junior-programeer/ProyectoRobot/docs/diagramas/diagrama de bloques.jpeg

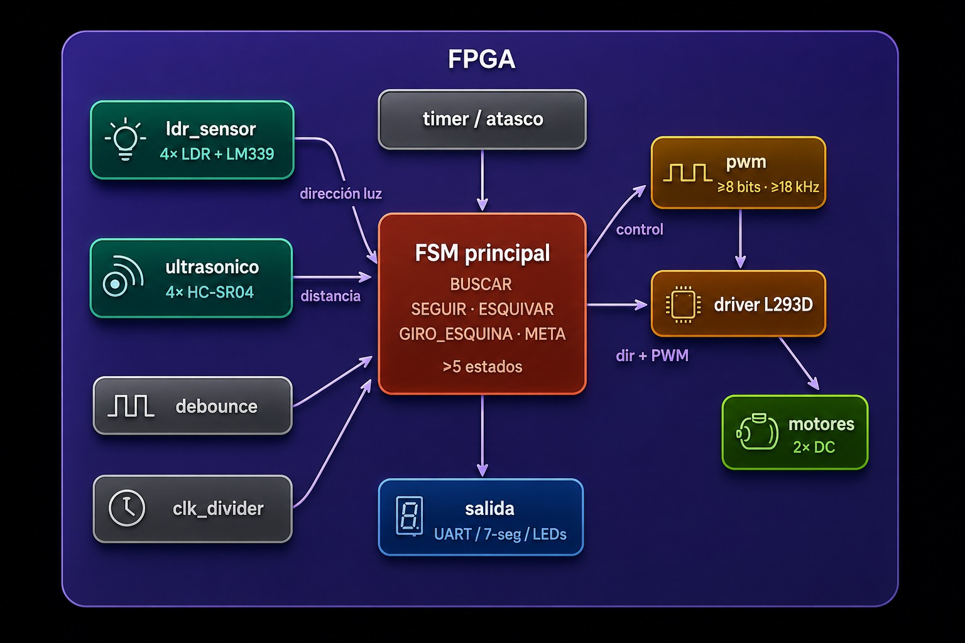
docs/diagramas/diagrama de bloques.jpeg
