junior-programeer/ProyectoRobot/docs/diagramas/diagrama fsm.png

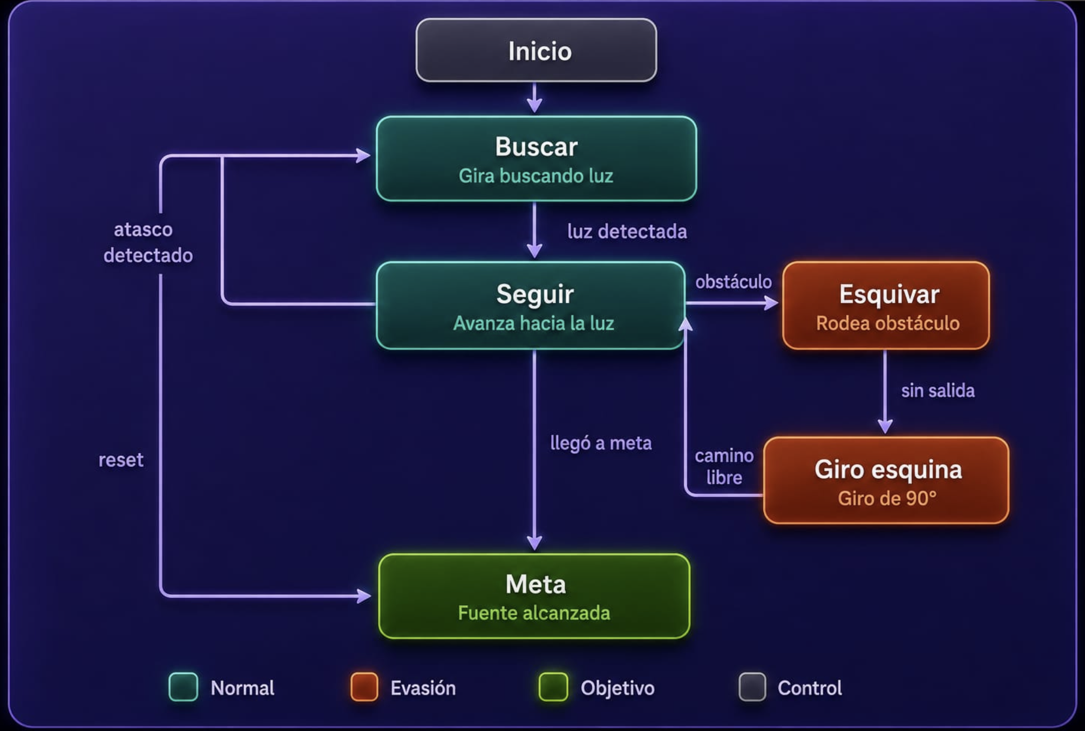
docs/diagramas/diagrama fsm.png
