junior-programeer/ProyectoRobot/docs/diagramas/diagrama-esquematico (patigrama)/placeholder.md

# Esquemático
El diagrama esquemático del circuito. Se muestran las conecciones y el alambrado necesario para el funcionamiento correcto de los sistemas de seguimiento y detección de obstaculos.
