junior-programeer/ProyectoRobot/codigo-vhdl/placeholder.md

# Código VHDL
Aquí va el código fuente del robot.
