junior-programeer/ProyectoRobot/docs/pines-fpga/placeholder.md

# Restricciones de Pines FPGA
Aquí va la asignación de pines de la DE10-Lite.
