junior-programeer/ProyectoRobot/docs/simulaciones/placeholder.md

# Simulaciones y Testbench
Aquí van los archivos de simulación y testbench.
