junior-programeer/ProyectoRobot/docs/datasheets/placeholder.md

# Datasheets
Aquí van los datasheets de los componentes.
