junior-programeer/ProyectoRobot/docs/diagramas/diagrama-esquematico (patigrama)/RobotSeguidor_circuit.png

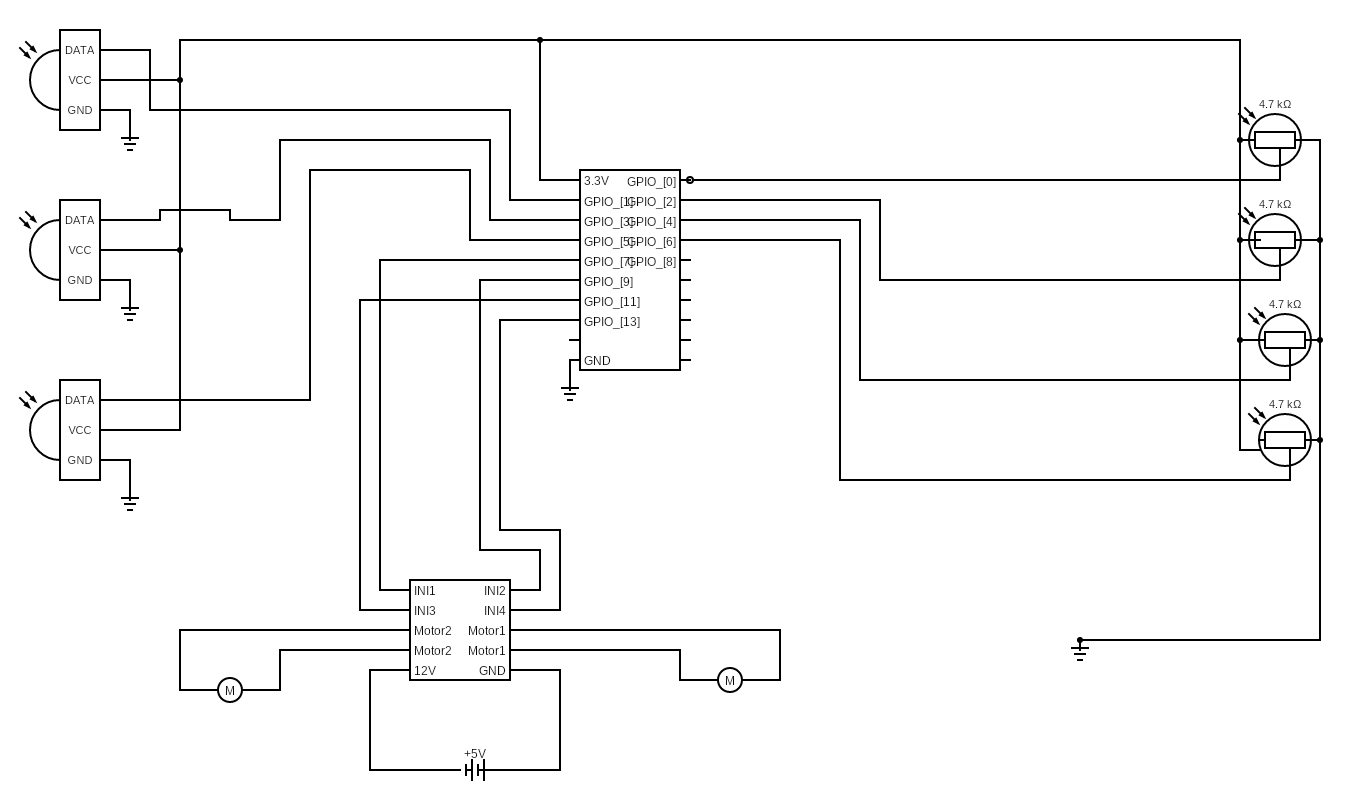
docs/diagramas/diagrama-esquematico (patigrama)/RobotSeguidor_circuit.png
