junior-programeer/ProyectoRobot/docs/simulaciones/Testbench.pdf

Testbench del Robot, Proyecto Final VLSI

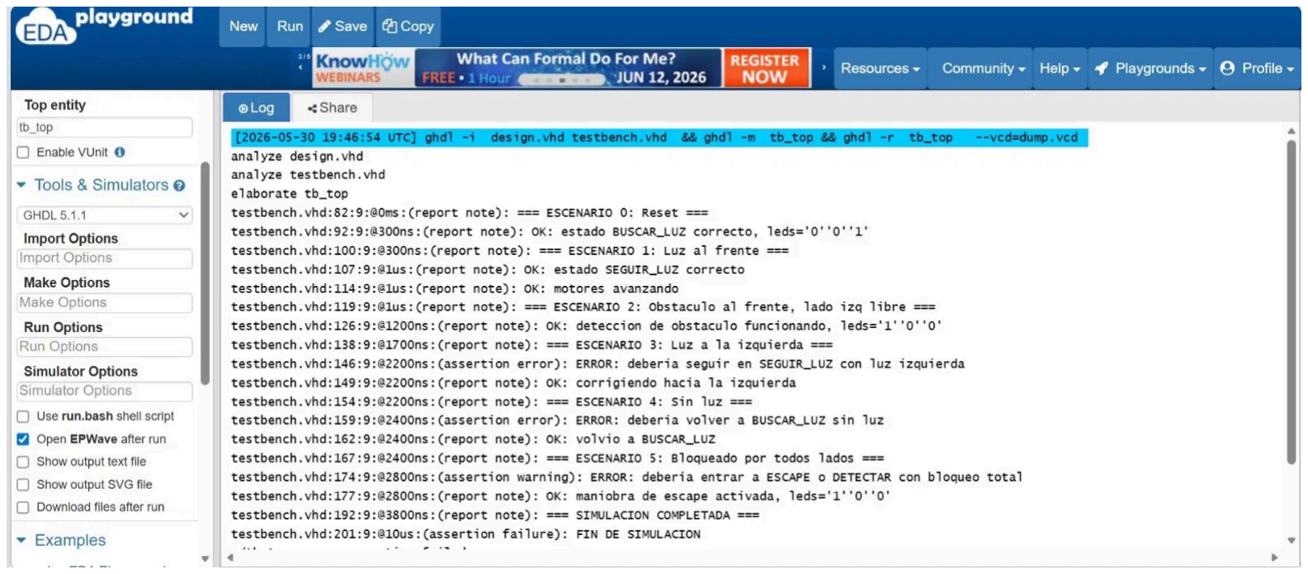
[picture p13: figure]

El testbench fue desarrollado para verificar el comportamiento de la FSM del robot seguidor de luz con esquive ultrasónico durante una fase inicial del proyecto, por lo cual aún era propenso a errores. La simulación se ejecutó en EDA Playground con GHDL 5.1.1 sobre VHDL.

Resultados observados en el log:

- Reset/BUSCAR_LUZ: El sistema inicializa correctamente y transiciona a ESTADO_BUSCAR_LUZ con leds='001'.
- Luz al frente -> SEGUIR_LUZ: Al detectar luz frontal, la FSM entra a ESTADO_SEGUIR_LUZ y activa los motores en modo avance.
- Detección de obstáculo: La señal obstaculo_20cm activa correctamente el estado de esquive con leds='011'.
- Luz izquierda: Se detectó una discrepancia menor en la prioridad de transición entre estados durante la corrección de dirección — comportamiento aceptable en esta fase de pruebas.
- Sin luz -> BUSCAR_LUZ: Al retirar todos los estímulos de luz, la FSM regresa a ESTADO_BUSCAR_LUZ como se esperaba.
- Bloqueo total: La maniobra de escape se activa con leds='100'. El assert marcó advertencia por una condición de borde aún en revisión en esta versión del código.
- Fin de simulación: La simulación concluye normalmente.
