junior-programeer/ProyectoRobot/(commit log)

2026-05-28 Llegue a modificar los No de Cuenta nadamas
    Updated team member information with account numbers.
2026-05-28 docs: agregar diagrama de bloques
2026-05-30 Add simulation tests documentation
    Se agregó una carpeta para las pruebas y el archivo Testbench
2026-05-30 crear carpeta manual de usuario
    Added user manual with usage instructions for the robot.
2026-06-01 Add files via upload
    Diagrama esquemático de conecciones entre sensores y actuadores del Robor.
2026-06-06 Revise user manual for light-following robot
    Updated the user manual for the light-following robot project, adding detailed sections on components, operation, calibration, and troubleshooting.
2026-06-06 Codigos del Proyecto Final de VLSI. Se han traido desde la rama 'codigo' de este mismo repositorio
2026-06-06 Limpieza de rastro de archivos en la carpeta raiz
2026-06-06 Ajuste de la estructura del repositorio en el README.md
2026-06-07 Update schematic diagram description
    Se proporciona una descripción más detallada del diagrama esquemático.
2026-06-08 Add pin assignment table for FPGA connections
2026-06-11 Archivo de simulación en una fase preliminar proy
